ahora3734/2026robo_2rd/esp32_pinmap.png

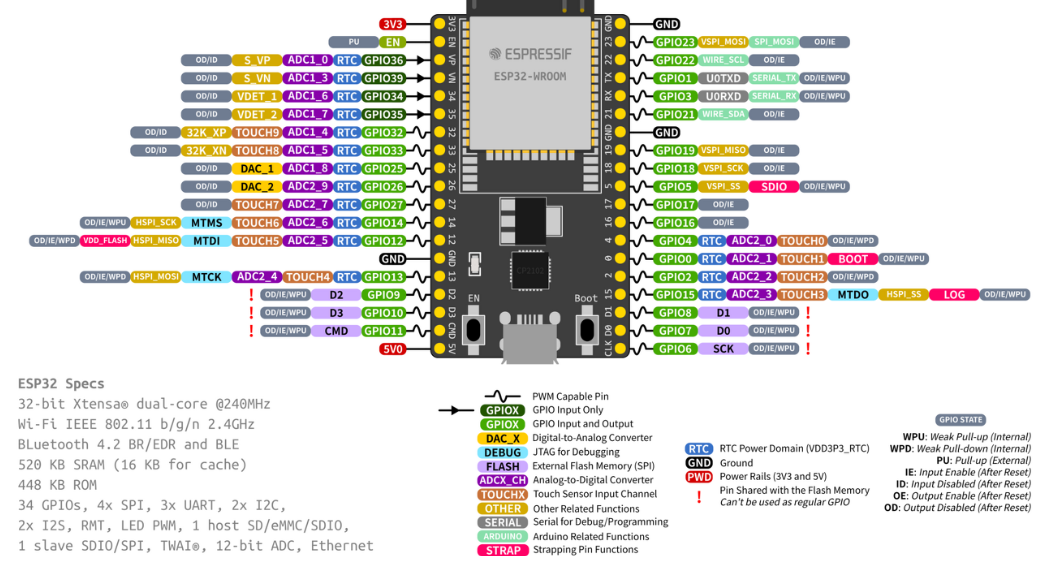
esp32_pinmap.png
