ahora3734/2026robo_2rd/drive.md

# 🏎️ ESP32 수동 주행 제어 가이드 (`drive.py`)

> **`drive.py`**는 ROS 2 환경 없이도 Jetson Orin Nano 터미널(또는 SSH)에서 키보드 입력을 통해 고카트(ESP32 모터 제어기)를 실시간으로 직접 수동 원격 조종(Teleoperation)할 수 있도록 제작된 단독 CLI 제어 스크립트입니다.

---

## 📌 목차
1. [핵심 기능 및 특징](#1-핵심-기능-및-특징)
2. [조작 키 바인딩 레퍼런스](#2-조작-키-바인딩-레퍼런스)
3. [주요 파라미터 및 설정값](#3-주요-파라미터-및-설정값)
4. [코드 아키텍처 및 내부 로직](#4-코드-아키텍처-및-내부-로직)
5. [ESP32 시리얼 통신 규격](#5-esp32-시리얼-통신-규격)
6. [실행 방법 및 운영 팁](#6-실행-방법-및-운영-팁)

---

## 1. 핵심 기능 및 특징

- **크루즈 컨트롤 (Cruise Control)**:
  - `W`(전진) 또는 `S`(후진) 키를 한 번 누르면 키에서 손을 떼더라도 해당 속도로 주행을 지속합니다.
- **조향 원점 자동 복귀 (Self-Centering)**:
  - `A`(좌회전), `D`(우회전) 키를 누르는 동안 `20°/s`로 꺾이며(최대 `±35°`, 짧게 한 번 누르면 약 `13°`), 손을 떼고 `0.65초`가 경과하면 핸들이 중앙(`0.0°`)으로 부드럽게 자동 복귀합니다.
  - 복귀 대기 시간(`0.65초`)은 터미널 키 반복 지연(약 500ms)보다 길게 잡아, 키를 누르고 있는 동안 핸들이 중간에 풀리지 않도록 했습니다.
- **부드러운 가감속 & 조향 램핑 (Ramping)**:
  - 모터 드라이버 보호 및 급격한 토크 변화로 인한 차체 충격을 방지하기 위해 틱당 PWM 및 조향각을 점진적으로 증가/감소시킵니다.
- **실시간 ANSI ASCII 터미널 대시보드 (HUD)**:
  - 별도 GUI 없이도 터미널 화면 깜빡임 없이 PWM 게이지(`█`), 조향 게이지(`O`), 기어 상태, 시동 상태를 실시간 시각화합니다.
- **2중 안전 설계 (Arming & Emergency Stop)**:
  - 오조작 방지를 위해 최초 실행 시 `DISARMED` 상태로 대기하며, `E` 키를 눌러 시동(`ARM`)을 켜야만 모터가 동작합니다.
  - `SPACE` 키 입력 시 감속 램프 없이 주행 PWM이 즉시 `0`이 되고, 조향은 중앙(`0°`)으로 복귀합니다.

---

## 2. 조작 키 바인딩 레퍼런스

| 키 | 분류 | 동작 설명 |
| :---: | :---: | :---|
| **`E`** | **시동** | **엔진 시동 켜기 (ARM)** (최초 실행 시 반드시 입력 필요) |
| **`W`** | **주행** | **전진 크루즈 주행** (현재 기어의 최대 PWM으로 목표 속도 설정) |
| **`S`** | **주행** | **후진 크루즈 주행** (현재 기어의 최대 PWM 후진 목표 설정) |
| **`SPACE`** | **안전** | **비상 즉시 정지** (모터 PWM 0 즉시 정지, 조향 각도 0 정렬) |
| **`A`** | **조향** | **좌회전** (누르는 동안 `20°/s`, 한계값: `-35°`) |
| **`D`** | **조향** | **우회전** (누르는 동안 `20°/s`, 한계값: `+35°`) |
| **`C`** | **조향** | **핸들 즉시 중앙 정렬** (주행 속도는 유지한 채 조향만 0도로 즉시 복귀) |
| **`1` ~ `4`** | **기어** | **1단 ~ 4단 기어 변속** (주행 중 즉시 반영) |
| **`ESC`** | **종료** | **프로그램 안전 종료** (정지 명령 3회 송신 후 포트 해제) |

---

## 3. 주요 파라미터 및 설정값

소스 코드 상단([`drive.py:L12-L30`](file:///c:/Users/ahora/Desktop/2026robo_2rd/drive.py#L12-L30))에서 하드웨어 특성에 맞게 조정할 수 있는 핵심 상수들입니다:

```python
SERIAL_PORT = "/dev/esp32"        # ESP32 시리얼 디바이스 포트
BAUDRATE = 115200                 # 통신 보레이트

# 기어(속도) 단계별 최대 PWM 설정 (0 ~ 255)
GEARS = {
    '1': 80,                      # 1단 (저속 / 안전)
    '2': 130,                     # 2단 (중속)
    '3': 180,                     # 3단 (고속)
    '4': 255                      # 4단 (최대 속도)
}

# 조향 설정 (단위: 도, ESP32 MAX_STEER_ANGLE_DEG = 35.0과 일치)
MAX_STEER = 35.0                  # 최대 조향 각도 한계 (±35°)
STEER_ACTIVE_RATE = 1.0           # A/D 누를 때 틱당 조향 변화량 (20Hz 기준 20°/s)
STEER_RETURN_RATE = 3.0           # 손을 뗐을 때 틱당 복귀량 (20Hz 기준 60°/s)

# 가감속 (Ramp) 파라미터
PWM_ACCEL_STEP = 15.0             # 틱당 가속 증가폭
PWM_DECEL_STEP = 30.0             # 틱당 감속 감소폭 (제동 안정성)

# 주기 및 타이머
LOOP_RATE_HZ = 20                 # 제어 루프 주기 (20Hz = 50ms)
STEER_TIMEOUT = 0.65              # A/D 키 입력 중단 후 원점 복귀 대기 시간(초)
```

> **조향 단위 주의**: ESP32 펌웨어는 받은 조향값을 `±35°`로 잘라냅니다(`constrain`). `MAX_STEER`를 35보다 크게 설정하면 바퀴는 더 꺾이지 않고 중앙 복귀만 늦어지므로, 펌웨어의 `MAX_STEER_ANGLE_DEG`와 같은 값으로 유지하세요.

---

## 4. 코드 아키텍처 및 내부 로직

### 4.1 클래스 구조: `TeleopManual`
- **[`connect_serial()`](file:///c:/Users/ahora/Desktop/2026robo_2rd/drive.py#L54-L65)**:
  - `/dev/esp32` 포트에 115200bps 속도로 시리얼 연결을 생성하고 입출력 버퍼를 초기화합니다.
- **[`print_dashboard()`](file:///c:/Users/ahora/Desktop/2026robo_2rd/drive.py#L66-L103)**:
  - ANSI 시퀀스(`\033[H\033[J`)를 사용하여 화면을 부드럽게 갱신합니다.
  - 현재 PWM 속도 바(`██████-------`)와 조향 바(`-------O-------`)를 터미널 그래픽으로 표현합니다.
- **[`run()`](file:///c:/Users/ahora/Desktop/2026robo_2rd/drive.py#L104-L208)**:
  - `SPACE` 입력 시 `target_pwm`과 `current_pwm`을 모두 `0`으로 만들어 램프 없이 즉시 정지합니다.
  - `tty.setcbreak()`: 키보드 엔터 키 없이 단일 키 입력을 즉시 캡처합니다.
  - `select.select()`: 논블로킹 방식으로 입력 버퍼를 비워 입력 랙(Lag)을 방지합니다.
  - 조향 타임아웃 감지: `now - last_steer_input_time > 0.65s` 시 목표 조향각을 `0.0`으로 자동 재설정합니다.
  - 램핑 연산: `current_pwm`과 `current_steer`를 목표값으로 점진적 수렴시킵니다.
  - 시리얼 명령 전송: 연산된 최종 명령을 ESP32에 전송합니다.
- **[`shutdown()`](file:///c:/Users/ahora/Desktop/2026robo_2rd/drive.py#L209-L221)**:
  - 종료 시 차량이 관성으로 계속 달리는 것을 방지하기 위해 정지 명령(`w,0,0.0,0\n`)을 3회 연속 전송한 뒤 시리얼을 닫고, 터미널 설정을 원래대로 복구(`termios.tcsetattr`)합니다.

---

## 5. ESP32 시리얼 통신 규격

- **통신 설정**: 115200 bps, 8N1
- **송신 포맷**: `w,{PWM},{STEER},{HOLD}\n`
  - **`PWM`**: 전진/후진 구동 모터 속도 (`-255 ~ 255`, 정수형)
    - 코드 내부에서 `cmd_pwm = -int(round(self.current_pwm))`으로 모터 배선 극성에 맞추어 부호 반전되어 송신됩니다.
  - **`STEER`**: 전륜 조향 각도 (`-35.0 ~ 35.0`도, 소수점 2자리)
  - **`HOLD`**: 정지 조향 허용 (`1`이면 `PWM`이 `0`이어도 조향 모터 구동)
- **전송 예시** (`PWM` 부호는 위의 반전이 적용된 값입니다):
  ```text
  w,-130,-35.00,1\n   # 2단 속도 전진(W) + 좌회전 35도
  w,80,0.00,0\n       # 1단 속도 후진(S) + 중앙 정렬
  w,0,0.00,0\n        # 전체 정지
  ```
- **정지 상태 조향**: ESP32 펌웨어는 `PWM`이 `0`이면 기본적으로 조향 모터를 끕니다. `drive.py`는 조향 중이거나 복귀 중일 때 `HOLD=1`을 보내므로 정지 상태에서도 `A`/`D` 조향이 동작합니다.

---

## 6. 실행 방법 및 운영 팁

### 6.1 실행 환경 요구사항
- **지원 OS**: Ubuntu Linux 20.04 / 22.04 LTS (Jetson Orin Nano / 일반 Linux PC)
- **의존 라이브러리**: `pyserial` (`pip install pyserial`)
  > **주의**: `termios` 및 `tty`는 POSIX(Linux/macOS) 표준 모듈이므로 Windows 일반 CMD/PowerShell에서는 직접 실행할 수 없습니다.

### 6.2 실행 단계
1. **ESP32 권한 개방**:
   ```bash
   sudo chmod 666 /dev/esp32
   ```
2. **스크립트 실행**:
   ```bash
   python3 drive.py
   ```
3. **주행 시작 절차**:
   1. 대시보드가 뜨면 먼저 **`E`** 키를 눌러 `[🟢 ENGINE ARMED]` 상태로 전환합니다.
   2. 숫자 키 **`1` ~ `4`**를 눌러 원하는 주행 기어를 선택합니다.
   3. **`W`** 키를 눌러 전진을 시작합니다.
   4. **`A` / `D`** 키를 눌러 조향합니다 (누르는 동안 20°/s, 손을 떼고 0.65초 후 직진으로 복귀, `C`로 즉시 중앙 정렬).
   5. 정지할 때는 **`SPACE`** 키를 누릅니다.
   6. 테스트를 마친 후 **`ESC`**를 누르면 안전하게 종료됩니다.
