ahora3734/2026robo_2rd/dashboard_preview.md

# 🏎️ 고카트 자율주행 통합 관제탑 화면 미리보기 (`web_dashboard.py`)

`web_dashboard.py`를 실행하면(보통 `start.sh`가 함께 실행) 브라우저에 아래와 같은 **4분할 화면**이 전체 화면 크기로 표시됩니다. 이 문서는 코드([`web_dashboard.py`](web_dashboard.py)의 `INDEX_HTML`)를 기준으로 그린 화면 구조도이며, 실제 화면은 검은 배경에 하늘색/초록색 네온 스타일입니다.

> [!TIP]
> **접속 주소**: [http://127.0.0.1:5000](http://127.0.0.1:5000)
> `start.sh`로 실행하면 웹 서버가 응답하는 즉시 브라우저가 자동으로 열립니다. 같은 네트워크의 다른 PC에서는 `http://<Jetson IP>:5000`으로 접속할 수 있습니다.

---

## 🖥️ 1. 전체 화면 구성 (시작 직후, 센서 연결 전)

아래는 센서·목적지가 아직 없을 때의 초기 화면입니다. 화면은 0.5초마다 `/api/data`를 받아 갱신됩니다.

```text
┌────────────────────────────────────────┬────────────────────────────────────────┐
│ 내비게이션 / 하이브리드 경로 추적      │ YOLO 실시간 AI 비전                    │
│────────────────────────────────────────│────────────────────────────────────────│
│  ┌──────────────────────────────────┐  │                                        │
│  │     지도 클릭 또는 버튼으로      │  │                                        │
│  │       목적지를 설정하세요.       │  │     (yolo26n.py가 보내는 /yolo_stream  │
│  │            대기 중...            │  │      카메라 영상이 꽉 차게 표시)       │
│  │  [ 정문 ] [ 체육관 ] [ 급식소 ]  │  │                                        │
│  │  [외부 장소 검색      ] [검색]   │  │      영상이 없으면 검은 화면           │
│  └──────────────────────────────────┘  │                                        │
│                                        │                                        │
│              ^  (차량 위치)            │                                        │
│                                        │                                        │
│GPS 연결 대기 중 | 36.056400, 129.371500│                                        │
├────────────────────────────────────────┼────────────────────────────────────────┤
│ Cyberpunk Radar / SLAM Map (10.0m)     │ 차량 상태 디지털 클러스터              │
│────────────────────────────────────────│────────────────────────────────────────│
│                          [HD RADAR SYS]│   ╭─────╮                              │
│               10M                      │   │  0  │  [ WAITING_FOR_NAV ]         │
│           .  .  7.5M .  .              │   │ PWM │  자율주행 대기               │
│        .    .  5.0M  .    .            │   ╰─────╯                              │
│       .   .  . 2.5M .  .   .           │  o GPS  o LiDAR  o IMU  o YOLO         │
│      .  .   .   ^    .   .  .          │ 조향 캘리브레이션 [o ALIGN OK]         │
│      ::::::: (후방 음영) :::::::       │ -35°(좌) ━━━━━━━━┃━━━━━━━━ +35°(우)    │
│                                        │  실제 +0.0° │ POT: 2048 │ 목표 +0.0°   │
│ 점 색상: 빨강<=1.5m 노랑<=3m 하늘>3m   │ 방위각  │ CTE    │ 라이다 │ YOLO       │
│ [자동 고정 | 반경 10m | 거리별 위험도] │ FAULT   │ -- m   │ --     │ CLEAR      │
│                                        │            [SPACE 비상정지 | R 해제]   │
└────────────────────────────────────────┴────────────────────────────────────────┘
```

> 그림의 `o`는 센서 LED입니다. 초기 화면에서는 GPS·LiDAR·IMU가 🔴, YOLO는 🟢로 표시되고, IMU 칸은 빨간 `FAULT`로 보입니다.

| 위치 | 패널 | 표시 내용 | 데이터 출처 (ROS 2 토픽) |
| :---: | :--- | :--- | :--- |
| 좌상 | **내비게이션 지도** | Leaflet 지도(다크 반전), 차량 위치(초록 ▲), 경로선(하늘색), 다음 지점 안내·거리, GPS 상태 | `/gps_pos`, `/gps_status`, `/nav_path_data` |
| 우상 | **YOLO AI 비전** | YOLO 인식 결과가 그려진 카메라 영상 (MJPEG 스트림 `/video_feed`) | `/yolo_stream` |
| 좌하 | **레이더 / SLAM** | 반경 10m 동심원, 회전하는 스캔 빔, 라이다 점, SLAM 점유 격자(노란색 = 장애물) | `/scan_filtered`, `/map` |
| 우하 | **디지털 클러스터** | PWM 링 게이지, 주행 상태, 센서 LED, 조향 캘리브레이션, 방위각/CTE/라이다/YOLO | `/vehicle_status`, `/imu_detail`, `/esp32_raw_status` |

---

## 🚘 2. 디지털 클러스터 (우하단) 상세

| 항목 | 표시 | 의미 |
| :--- | :--- | :--- |
| **PWM 링 게이지** | `0` ~ `255`, 초록 링이 차오름 | main_fusion이 내보내는 주행 PWM |
| **상태 배지** | `WAITING_FOR_NAV`, `REMOTE_ESTOP`, `SENSOR_FAULT` 등 | main_fusion 상태 머신의 현재 상태 |
| **상태 메시지** | `내비게이션 경로 대기`, `원격 비상정지 (대시보드)` 등 | 상태에 대한 설명 |
| **센서 LED** | 🟢 정상 / 🔴 이상 | GPS: 실제 GPS 수신, LiDAR: 전방 거리 0~12m, IMU: 1초 이내 수신, YOLO: 인식 값이 비어 있지 않음 (기본값이 `CLEAR`라 비전 노드가 없어도 초록으로 보임) |
| **조향 바** | `-35°(좌)` ~ `+35°(우)`, 가운데 초록선 = 중앙 | ESP32가 보고한 **실제** 조향각(가변저항 기준) |
| **정렬 배지** | `● ALIGN OK` / `▶ 우회전 n°` / `◀ 좌회전 n°` | 실제 조향각이 ±1° 이내면 정렬 완료 |
| **실제 / POT / 목표** | `+0.0°` / `POT: 2048` / `+0.0°` | 실제 조향각, 가변저항 ADC 원시값(핀 32), main_fusion 목표 조향각 |
| **방위각** | `123.4°` 또는 🔴 `FAULT` | IMU 헤딩 (1초 이상 수신 없으면 FAULT) |
| **경로 편차 (CTE)** | `0.35 m` | 경로선에서 벗어난 거리 |
| **전방 라이다** | ⚪ > 3m / 🟡 ≤ 3m / 🔴 ≤ 1.5m | 정면 장애물 거리 |
| **YOLO 인식** | `CLEAR`, `PERSON` 등 | 비전 노드의 판단 결과 |

---

## 🛑 3. 키보드 비상정지 화면

화면 오른쪽 아래에는 항상 `⌨ SPACE 비상정지 | R 해제` 안내가 떠 있습니다. 대시보드 창에 포커스가 있는 상태에서 무선 키보드의 **SPACE**를 누르면 화면 전체가 아래처럼 바뀝니다. (오버레이는 반투명이라 뒤의 4분할 화면이 비쳐 보입니다.)

### 3.1 SPACE 직후 — 🟡 노란 테두리 (정지 확인 대기)

main_fusion이 아직 정지 상태를 보고하지 않은 순간입니다. 확인될 때까지 0.5초마다 정지 명령을 재전송합니다.

```text
~~~~~~~~~~~~~~~~~~~~~~~~~~~~~~~~~~~~~~~~~~~~~~~~~~~~~~~~~~~~~~~~~~~~~~~~~~~~~~~~~~~
~                                                                                 ~
~                                                                                 ~
~                ┌──────────────────────────────────────────────┐                 ~
~                │                                              │                 ~
~                │              정지 명령 전송 중               │                 ~
~                │                                              │                 ~
~                │   차량 정지 확인 대기 중... (계속 재전송)    │                 ~
~                │                                              │                 ~
~                └──────────────────────────────────────────────┘                 ~
~                                                                                 ~
~                                                                                 ~
~~~~~~~~~~~~~~~~~~~~~~~~~~~~~~~~~~~~~~~~~~~~~~~~~~~~~~~~~~~~~~~~~~~~~~~~~~~~~~~~~~~
```

### 3.2 정지 확인 — 🔴 빨간 테두리

main_fusion이 `REMOTE_ESTOP` 상태가 되어 PWM 0을 내보내고 있음을 확인한 상태입니다. 클러스터의 상태 배지도 `REMOTE_ESTOP`으로 바뀝니다.

```text
###################################################################################
#                                                                                 #
#                                                                                 #
#                ┌──────────────────────────────────────────────┐                 #
#                │                                              │                 #
#                │                 비 상 정 지                  │                 #
#                │                                              │                 #
#                │     R 키를 누르면 자율주행을 재개합니다      │                 #
#                │                                              │                 #
#                └──────────────────────────────────────────────┘                 #
#                                                                                 #
#                                                                                 #
###################################################################################
```

### 3.3 해제

**R** 키를 누르면 `RELEASE`가 전송되고 오버레이가 사라지며 자율주행이 재개됩니다. (검색창에 입력 중일 때는 R이 무시됩니다.)

| 키 | 동작 | 비고 |
| :---: | :--- | :--- |
| **SPACE** | 비상정지 (`/estop` ← `STOP`) | 검색창 입력 중에도 항상 동작 (검색창에 띄어쓰기 입력 불가) |
| **R** | 정지 해제 (`/estop` ← `RELEASE`) | 검색창 입력 중에는 무시 |

> [!WARNING]
> 키보드 비상정지는 **대시보드 브라우저 창에 포커스가 있고**, `web_dashboard.py`와 `main_fusion.py`가 모두 실행 중일 때만 동작하는 보조 수단입니다. 하드웨어 킬스위치를 항상 함께 준비하세요.

---

## 🎮 4. 대시보드 조작 가이드

1. **빠른 목적지 설정**: 좌측 상단 카드의 **[정문]**, **[체육관]**, **[급식소]** 버튼을 클릭합니다. 경로가 계산되면 지도에 하늘색 경로선이 그려집니다.
2. **지도 직접 클릭**: 지도의 원하는 지점을 클릭하면 `사용자 지정` 목적지 마커가 생기고 그 위치로 경로를 요청합니다.
3. **장소 검색**: 검색창에 장소명을 입력하고 **[검색]**을 누릅니다. 교내 장소(`정문`, `체육관`, `급식소`, `삼거리`)는 자동 매칭되고, 그 외는 T-Map POI 검색 결과의 첫 번째 장소로 설정됩니다. (`TMAP_APP_KEY` 환경변수 필요)
4. **지도 자동 추적**: 평소에는 지도가 차량 위치를 따라가고, 지도를 드래그·줌하면 3초 동안 자동 추적이 멈춥니다.
5. **주행 중 비상정지**: 키보드 **SPACE** (위 3절 참고).
