ahora3734/2026robo_2rd/esp32_auto/esp32_auto.ino

// esp32_auto.ino
// ==============================================================================
// ROS 2 - ESP32 Go-Kart Firmware (32번 핀 가변저항 피드백 폐루프 조향 제어)
// ==============================================================================
// - 32번 핀(ADC1)으로 핸들 가변저항 값을 읽어 현재 조향 각도를 산출
// - 젯슨(Jetson)으로부터 수신한 목표 조향각과 비교하여 실시간 P/PID 조향 모터 제어
// - 젯슨으로 현재 가변저항 ADC 및 각도 텔레메트리를 시리얼 JSON으로 실시간 피드백 전송
// - 통신 두절(0.5초 초과) 시 안전 워치독 작동으로 전 모터 즉각 정지
// - <PWM,STEER,1> 수신 시 정지 상태(PWM 0)에서도 조향 (장애물 회피 전 핸들 미리 꺾기)
// ==============================================================================

#include <Arduino.h>

// --- [1. 하드웨어 핀 맵] ---
#define LEFT_PWM_PIN   18
#define LEFT_DIR_PIN   19
#define RIGHT_PWM_PIN  21
#define RIGHT_DIR_PIN  22

#define STEER_PWM_PIN  25
#define STEER_DIR_PIN  26

#define POT_PIN        32  // 핸들 가변저항 아날로그 핀 (ESP32 ADC1_CH4)

// --- [2. 캘리브레이션 및 제어 파라미터 (차량 환경에 맞춰 조정)] ---
// 핸들이 정중앙일 때의 가변저항 ADC 값 (0 ~ 4095 중 대략 중앙 2048 전후)
int POT_CENTER = 2048;

// 핸들 물리적 한계점 (과회전으로 인한 기구물 파손 방지)
int POT_MIN_LIMIT = 600;   // 최대 좌회전 또는 우회전 끝단 ADC
int POT_MAX_LIMIT = 3500;  // 최대 우회전 또는 좌회전 끝단 ADC

// [REVIEW #4] 각도 매핑 끝점(±MAX_STEER_ANGLE_DEG)을 한계점보다 안쪽에 두는 마진(ADC)
// - 풀 조향 명령(±35°)이 곧바로 한계 차단에 걸리지 않도록 함
int POT_LIMIT_MARGIN = 100;

// 조향 불감대 (Deadband): 목표 각도와 오차가 이 범위 이내면 모터 정지 (모터 발열/떨림 방지)
const float STEER_DEADBAND_DEG = 1.0; 

// 최대 허용 조향각 (도, deg)
const float MAX_STEER_ANGLE_DEG = 35.0;

// 조향 모터 P 게인 (오차에 따른 모터 속도 비례 상수)
const float STEER_KP = 5.0;
const int STEER_MIN_PWM = 85;   // 지면 마찰 부하에서도 기어를 돌리기 시작하는 최소 PWM (65 -> 85 상향)
const int STEER_MAX_PWM = 180;  // 조향 모터 안전 최대 PWM (스톨 차단이 없으므로 실측 전까지 180 유지)

// 방향 반전 옵션 (테스트 후 핸들이 반대로 돌면 true <-> false 전환)
#define REVERSE_STEER_MOTOR  false
#define REVERSE_POT_SENSOR   false

// 조향 시작 불감대: 모터가 멈춰 있을 때는 오차가 이 값을 넘어야 다시 구동 (진동으로 핸들이 살짝 틀어져도 무시)
// - 일단 구동을 시작하면 STEER_DEADBAND_DEG 이내까지 돌린 뒤 멈춤
const float STEER_DEADBAND_START_DEG = 2.5;

// --- [3. 통신 및 상태 변수] ---
bool is_armed = false;
int target_drive_pwm = 0;
float target_steer_angle = 0.0;
// 정지 조향 허용: <PWM,STEER,1> 수신 시 PWM 0에서도 조향 모터 구동 (장애물 회피 전 핸들 미리 꺾기)
bool steer_hold_requested = false;
unsigned long last_steer_change_time = 0;
const unsigned long STEER_SETTLE_GRACE_MS = 1500; // 목표 조향각 변경 후 정지 상태에서도 추종을 유지할 시간

float current_steer_angle = 0.0;
float filtered_pot_adc = 2048.0;

unsigned long last_comm_time = 0;
const unsigned long WATCHDOG_TIMEOUT_MS = 500;

unsigned long last_telemetry_time = 0;
const unsigned long TELEMETRY_INTERVAL_MS = 50; // 20Hz 주기로 젯슨에 상태 전송

// [REVIEW #24] 구동 모터 PWM 주파수 및 정/역 전환 데드타임
// - 모터 드라이버가 지원하는 주파수인지 데이터시트 확인 (BTS7960 등은 ~25kHz 지원)
#define MOTOR_PWM_FREQ_HZ  20000
const unsigned long DRIVE_REVERSE_DEADTIME_MS = 150;
int last_drive_dir = 0;                 // -1 후진, 0 정지, +1 전진
unsigned long drive_reverse_start = 0;

// --- [함수 프로토타입] ---
void parseSerialDataSafe();
void updatePotentiometer();
void controlDriveMotors();
void controlSteerClosedLoop();
void stopAllMotors();
void sendTelemetryToJetson();

void setup() {
  Serial.begin(115200);

  pinMode(LEFT_PWM_PIN, OUTPUT);
  pinMode(LEFT_DIR_PIN, OUTPUT);
  pinMode(RIGHT_PWM_PIN, OUTPUT);
  pinMode(RIGHT_DIR_PIN, OUTPUT);
  pinMode(STEER_PWM_PIN, OUTPUT);
  pinMode(STEER_DIR_PIN, OUTPUT);

  pinMode(POT_PIN, INPUT);

  stopAllMotors();
  is_armed = false;

#if defined(ESP_ARDUINO_VERSION_MAJOR) && (ESP_ARDUINO_VERSION_MAJOR >= 3)
  // [REVIEW #24] 기본 ~1kHz는 가청 소음 -> 가청 대역 밖으로 (arduino-esp32 3.x API)
  // stopAllMotors()의 analogWrite로 핀이 LEDC에 연결된 뒤에 설정해야 적용됨
  analogWriteFrequency(LEFT_PWM_PIN, MOTOR_PWM_FREQ_HZ);
  analogWriteFrequency(RIGHT_PWM_PIN, MOTOR_PWM_FREQ_HZ);
  analogWriteFrequency(STEER_PWM_PIN, MOTOR_PWM_FREQ_HZ);
#endif

  // 부팅 시 초기 가변저항 값 안정화
  delay(100);
  filtered_pot_adc = analogRead(POT_PIN);
  updatePotentiometer();

  Serial.println(F("[ESP32] Ready - Closed Loop Steering with Potentiometer (Pin 32)"));
}

void loop() {
  // 1. 젯슨 명령 수신 및 파싱
  parseSerialDataSafe();

  // 2. 가변저항 ADC 필터링 및 현재 각도 계산
  updatePotentiometer();

  // 3. 안전 워치독 검사 (0.5초 통신 단절 시 정지)
  if (millis() - last_comm_time > WATCHDOG_TIMEOUT_MS) {
    is_armed = false;
    stopAllMotors();
  } else {
    if (is_armed) {
      controlSteerClosedLoop();
      controlDriveMotors();
    } else {
      stopAllMotors();
    }
  }

  // 4. 젯슨으로 현재 가변저항 및 조향각 피드백 텔레메트리 전송 (20Hz)
  if (millis() - last_telemetry_time >= TELEMETRY_INTERVAL_MS) {
    last_telemetry_time = millis();
    sendTelemetryToJetson();
  }

  delay(5);
}

// ==============================================================================
// 1. 시리얼 수신 파서: <PWM,STEER> 및 w,PWM,STEER 모두 지원 (C-스타일 고정 버퍼로 힙 단편화 원천 차단)
// ==============================================================================
static char rx_buf[64];
static uint8_t rx_idx = 0;

void parseSerialDataSafe() {
  while (Serial.available() > 0) {
    char c = (char)Serial.read();
    if (c == '\n' || c == '\r') {
      if (rx_idx == 0) continue;
      rx_buf[rx_idx] = '\0';

      int pwm_in = 0;
      float steer_in = 0.0f;
      int hold_in = 0;
      bool valid = false;

      // 포맷 A: esp32_bridge.py 표준 규격 <PWM,STEER> 또는 <PWM,STEER,HOLD> (예: <120,-15.20>, <0,35.00,1>)
      // - 세 번째 필드가 없으면 sscanf가 2를 반환하고 hold_in은 0 유지 (기존 형식 호환)
      if (rx_buf[0] == '<') {
        if (sscanf(rx_buf, "<%d,%f,%d>", &pwm_in, &steer_in, &hold_in) >= 2) {
          valid = true;
        }
      }
      // 포맷 B: 수동/키보드 명령 호환 w,PWM,STEER[,HOLD] / s,PWM,STEER[,HOLD]
      else if (rx_buf[0] == 'w' || rx_buf[0] == 's') {
        if (sscanf(rx_buf + 2, "%d,%f,%d", &pwm_in, &steer_in, &hold_in) >= 2) {
          valid = true;
        }
      }

      if (valid) {
        float new_steer = constrain(steer_in, -MAX_STEER_ANGLE_DEG, MAX_STEER_ANGLE_DEG);
        if (abs(new_steer - target_steer_angle) >= 0.3f || (target_drive_pwm != 0 && pwm_in == 0)) {
          last_steer_change_time = millis();
        }
        target_drive_pwm = pwm_in;
        target_steer_angle = new_steer;
        steer_hold_requested = (hold_in != 0);
        last_comm_time = millis();
        is_armed = true;
      }

      rx_idx = 0; // 다음 수신을 위해 인덱스 리셋
    } else {
      if (rx_idx < sizeof(rx_buf) - 1) {
        rx_buf[rx_idx++] = c;
      } else {
        // 비정상 패킷으로 인한 버퍼 오버플로우 방지
        rx_idx = 0;
      }
    }
  }
}

// ==============================================================================
// 2. 가변저항(32번 핀) 필터링 및 현재 조향각(deg) 변환
// ==============================================================================
void updatePotentiometer() {
  int raw_adc = analogRead(POT_PIN);

  // EMA 저주파 통과 필터 (노이즈 및 채터링 제거)
  filtered_pot_adc = (filtered_pot_adc * 0.8f) + (raw_adc * 0.2f);

  // ADC 값 -> 조향 각도(-MAX_STEER ~ +MAX_STEER) 매핑
  // [REVIEW #4] ±MAX_STEER는 한계점보다 POT_LIMIT_MARGIN만큼 안쪽에 대응시킴
  float angle = 0.0f;
  if (filtered_pot_adc >= POT_CENTER) {
    angle = (float)(filtered_pot_adc - POT_CENTER) / (float)((POT_MAX_LIMIT - POT_LIMIT_MARGIN) - POT_CENTER) * MAX_STEER_ANGLE_DEG;
  } else {
    angle = -(float)(POT_CENTER - filtered_pot_adc) / (float)(POT_CENTER - (POT_MIN_LIMIT + POT_LIMIT_MARGIN)) * MAX_STEER_ANGLE_DEG;
  }

  if (REVERSE_POT_SENSOR) {
    angle = -angle;
  }

  current_steer_angle = constrain(angle, -MAX_STEER_ANGLE_DEG, MAX_STEER_ANGLE_DEG);
}

// ==============================================================================
// 3. 조향 모터 폐루프(Closed-Loop) 비례 제어 (가변저항 피드백)
// ==============================================================================
void controlSteerClosedLoop() {
  // [기어 보호 1] 차량 정지 시(PWM == 0) 조향 모터 완전 OFF
  // - 정지 마찰력으로 인한 기어 파손/발열 방지
  // - 사람이 손으로 핸들을 자유롭게 돌려 대시보드 화면을 보며 영점(Center) 튜닝 가능!
  // - 예외 1: 젯슨이 정지 조향(HOLD=1)을 요청한 경우
  // - 예외 2: 목표 조향각이 방금 변경되었거나 방금 정지하여(1.5초 이내) 목표 각도로 복귀 중인 경우
  bool in_settle_grace = (millis() - last_steer_change_time) < STEER_SETTLE_GRACE_MS;
  if (abs(target_drive_pwm) == 0 && !steer_hold_requested && !in_settle_grace) {
    analogWrite(STEER_PWM_PIN, 0);
    return;
  }

  float error = target_steer_angle - current_steer_angle;

  // [기어 보호 2] 기구적 하드웨어 한계 보호
  // [REVIEW #4] 한계 방향으로 '더' 돌리려는 경우에만 차단 (중앙 복귀는 허용)
  // error > 0 이면 각도를 키우는 방향. REVERSE_POT_SENSOR면 각도와 ADC 방향이 반대.
  bool wants_adc_up = (error > 0) != REVERSE_POT_SENSOR;
  if ((filtered_pot_adc >= POT_MAX_LIMIT && wants_adc_up) ||
      (filtered_pot_adc <= POT_MIN_LIMIT && !wants_adc_up)) {
    analogWrite(STEER_PWM_PIN, 0);
    return;
  }

  // [기어 보호 3] 불감대(Deadband) 내에 도달하면 조향 모터 정지
  // 멈춰 있을 때는 STEER_DEADBAND_START_DEG를 넘어야 구동 시작, 구동 중에는 STEER_DEADBAND_DEG까지 돌림
  float deadband = (steer_motor_start_time == 0) ? STEER_DEADBAND_START_DEG : STEER_DEADBAND_DEG;
  if (abs(error) <= deadband) {
    analogWrite(STEER_PWM_PIN, 0);
    return;
  }

  // P 비례 제어로 필요 모터 속도 산출
  int steer_pwm = (int)(abs(error) * STEER_KP * 10.0f);
  steer_pwm = constrain(steer_pwm, STEER_MIN_PWM, STEER_MAX_PWM);

  // 핸들이 안 움직이는 시간에 비례해 PWM 상승 (움직이기 시작하면 위에서 시각이 갱신되어 원래 값으로 복귀)
  unsigned long stuck_ms = millis() - steer_motor_start_time;
  steer_pwm += (int)((STEER_MAX_PWM - steer_pwm) * stuck_ms / STEER_STALL_TIMEOUT_MS);
  steer_pwm = constrain(steer_pwm, STEER_MIN_PWM, STEER_MAX_PWM);

  // 회전 방향 결정
  bool turn_right = (error > 0);
  if (REVERSE_STEER_MOTOR) {
    turn_right = !turn_right;
  }

  digitalWrite(STEER_DIR_PIN, turn_right ? HIGH : LOW);
  analogWrite(STEER_PWM_PIN, steer_pwm);
}

// ==============================================================================
// 4. 좌/우 주행 모터 구동
// ==============================================================================
void controlDriveMotors() {
  int pwm_out = abs(target_drive_pwm);
  pwm_out = constrain(pwm_out, 0, 255);
  int dir = (target_drive_pwm > 0) ? 1 : ((target_drive_pwm < 0) ? -1 : 0);

  // [REVIEW #24] 전진<->후진 전환 시 PWM 0으로 잠시 멈춘 뒤 DIR 변경 (드라이버 보호)
  if (dir != 0 && last_drive_dir != 0 && dir != last_drive_dir) {
    analogWrite(LEFT_PWM_PIN, 0);
    analogWrite(RIGHT_PWM_PIN, 0);
    if (drive_reverse_start == 0) drive_reverse_start = millis();
    if (millis() - drive_reverse_start < DRIVE_REVERSE_DEADTIME_MS) return;
  }
  drive_reverse_start = 0;

  if (dir > 0) {
    digitalWrite(LEFT_DIR_PIN, HIGH);
    digitalWrite(RIGHT_DIR_PIN, HIGH);
    analogWrite(LEFT_PWM_PIN, pwm_out);
    analogWrite(RIGHT_PWM_PIN, pwm_out);
  } else if (dir < 0) {
    digitalWrite(LEFT_DIR_PIN, LOW);
    digitalWrite(RIGHT_DIR_PIN, LOW);
    analogWrite(LEFT_PWM_PIN, pwm_out);
    analogWrite(RIGHT_PWM_PIN, pwm_out);
  } else {
    analogWrite(LEFT_PWM_PIN, 0);
    analogWrite(RIGHT_PWM_PIN, 0);
  }
  // 정지(0)를 거친 방향 전환도 데드타임을 거치도록 마지막 구동 방향은 유지
  if (dir != 0) last_drive_dir = dir;
}

// ==============================================================================
// 5. 모터 전원 완전 차단
// ==============================================================================
void stopAllMotors() {
  analogWrite(LEFT_PWM_PIN, 0);
  analogWrite(RIGHT_PWM_PIN, 0);
  analogWrite(STEER_PWM_PIN, 0);
}

// ==============================================================================
// 6. 젯슨으로 텔레메트리 회신 (JSON 문자열 -> /esp32_raw_status)
// ==============================================================================
void sendTelemetryToJetson() {
  // 젯슨의 esp32_bridge.py 및 관제 화면에서 파싱하기 쉽도록 JSON 한 줄로 전송
  Serial.print(F("{\"pot\":"));
  Serial.print((int)filtered_pot_adc);
  Serial.print(F(",\"steer_cur\":"));
  Serial.print(current_steer_angle, 1);
  Serial.print(F(",\"steer_target\":"));
  Serial.print(target_steer_angle, 1);
  Serial.print(F(",\"pwm\":"));
  Serial.print(target_drive_pwm);
  Serial.print(F(",\"armed\":"));
  Serial.print(is_armed ? 1 : 0);
  Serial.print(F(",\"hold\":"));
  Serial.print(steer_hold_requested ? 1 : 0);
  Serial.println(F("}"));
}
