ahora3734/2026robo_2rd/(commit log)

2026-10-27 esp32_auto 폴더 구조 정리
2026-10-28 2026.10.27.13:30/차체 치수 넣음
2026-10-28 2026.10.28.drive.py 추가, 긴급정지 추가
2026-10-29 2026.10.29.9:58_젯슨에 clone하기 위한 gitignore수정
    [drive.py]
2026-10-29 2026.10.29.imu 수정
2026-10-29 gps포트수정. start.sh실행중일때 종료기능 추가
    [gps_tmap_nav.py, tmap.py]
2026-10-30 후진하던거 수정
2026-10-30 테스트2
2026-10-30 태스트복구
2026-10-30 테스트3
2026-10-30 현성이다
2026-10-30 4m세팅에서 2.5m세팅으로 수정
2026-10-31 핸들조향민감도 조절
2026-10-31 esp32포트 재설정
2026-10-31 esp32_auto, main_fusion을 main 기준으로 반영
2026-11-02 esp32 수정
2026-11-02 조향 제어 정리: 부드러운 조향 유지, 안전 동작 복구
    - esp32_auto: 조향 게인을 KP 5.0 / MIN 85 / MAX 180으로 조정
    - esp32_bridge: 조향 목표 변화율 제한 추가, 포트 열 때 리셋 방지 유지
    - main_fusion: 조향 추종 실패 고장 판정 복구, 고장 정지 중 조향 복귀 허용,
    기준을 20도/4초로 완화, 출발 시 방위 정렬(require_align) 유지
    - drive: 텔레메트리 표시와 정지 조향 추가, A/D 조향 속도를 20도/s로 제한
    - drive.md: 변경된 조작과 통신 규격 반영
2026-11-04 자율주행성공
